joshajohnson/nano-trackball/hardware/mechanicals-snzagkeys/bottom.stp

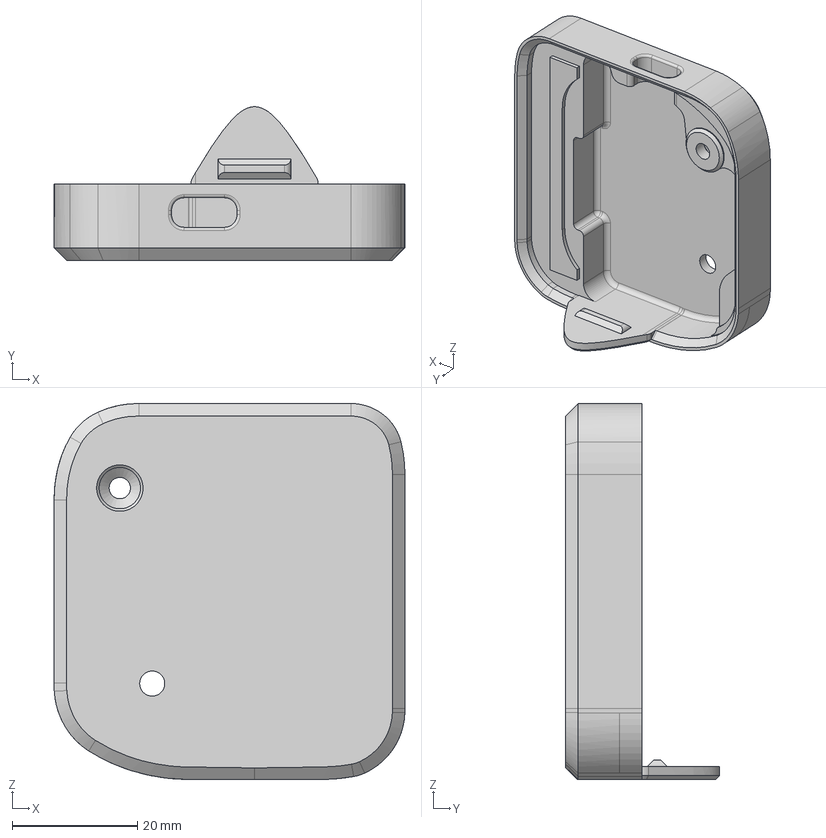
[picture p1: CAD file, 2021-08-11]
hardware/mechanicals-snzagkeys/bottom.stp
56.0 x 24.5 x 60.0 mm
