joshajohnson/nano-trackball/(list of files, cad)

Other CAD files:
hardware/mechanicals-snzagkeys/bottom.stl
