joshajohnson/nano-trackball/hardware/electronics-snzagkeys/outputs/schematic.pdf

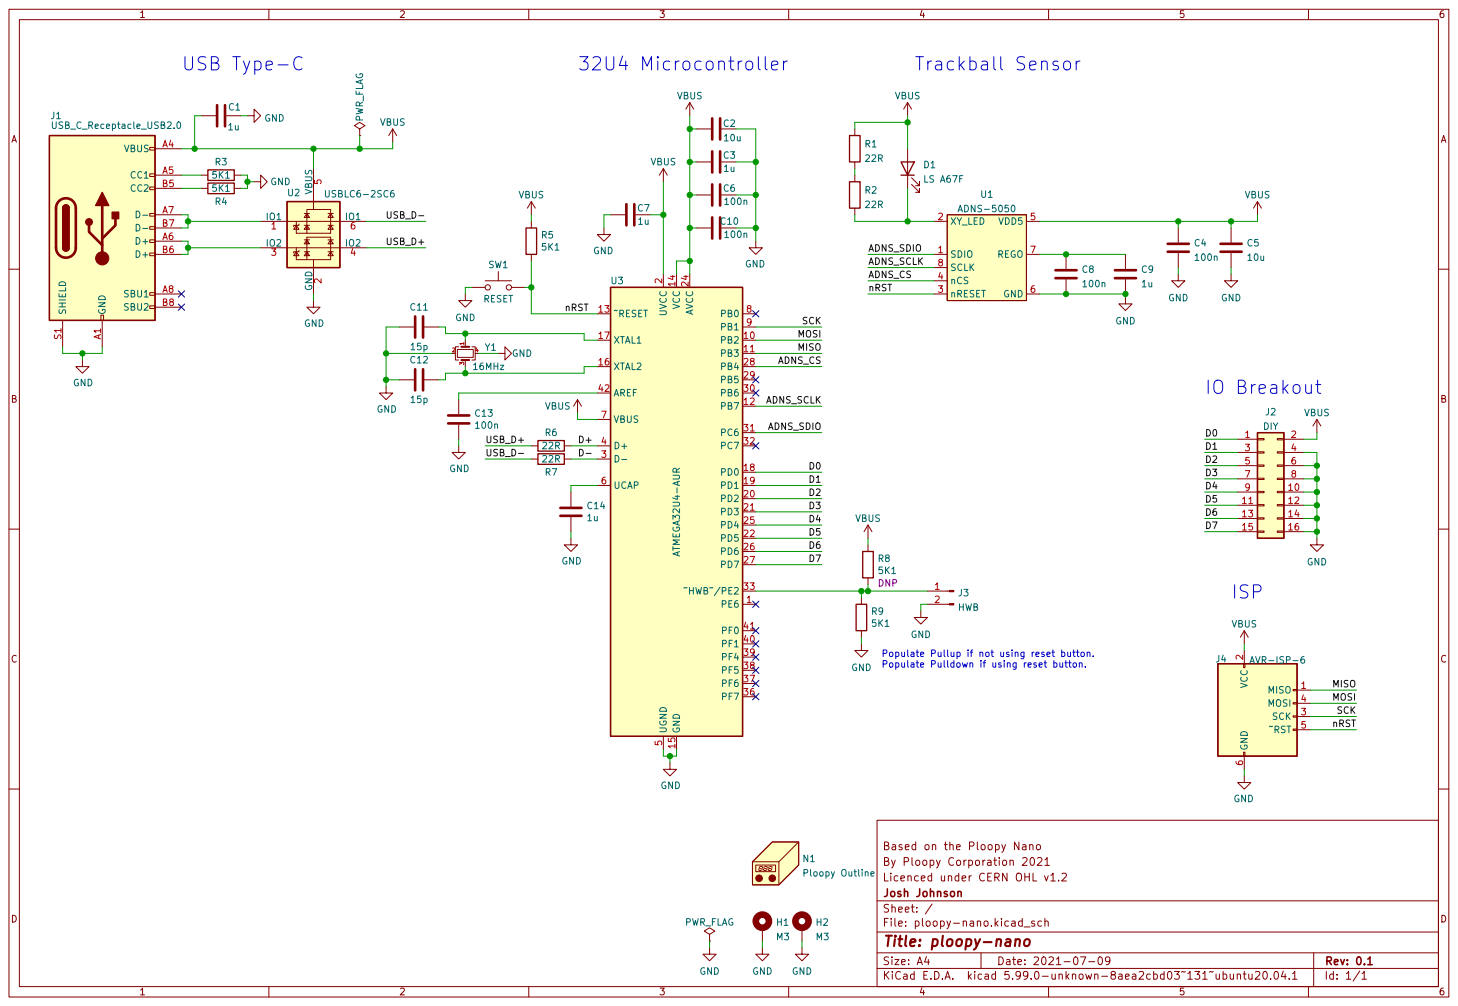
[picture p2: page 1]

2 PD2 20 PD3 21 PD5 22 AVCC 24 PD4 25 PD6 26 PD7 27 PB4 28 PB5 29 D- 3 PB6 30 PC6 31 PC7 32 ~HWB~/PE233 PF7 36 PF6 37 PF5 38 PF4 39 D+ 4 PF1 40 PF0 41 AREF 42 UGND

Populate Pullup if not using reset button.
Populate Pulldown if using reset button.

2 SCK 3 MOSI 4 ~RST 5 GND

Licenced under CERN OHL v1.2 By Ploopy Corporation 2021

File: ploopy-nano.kicad_sch Sheet: / Josh Johnson

Id: 1/1 Title: ploopy-nano
