joshajohnson/nano-trackball/hardware/electronics-snzagkeys/ploopy-nano.kicad_pcb

## KiCad design hardware/electronics-snzagkeys/ploopy-nano.kicad_pcb (2021-08-11)

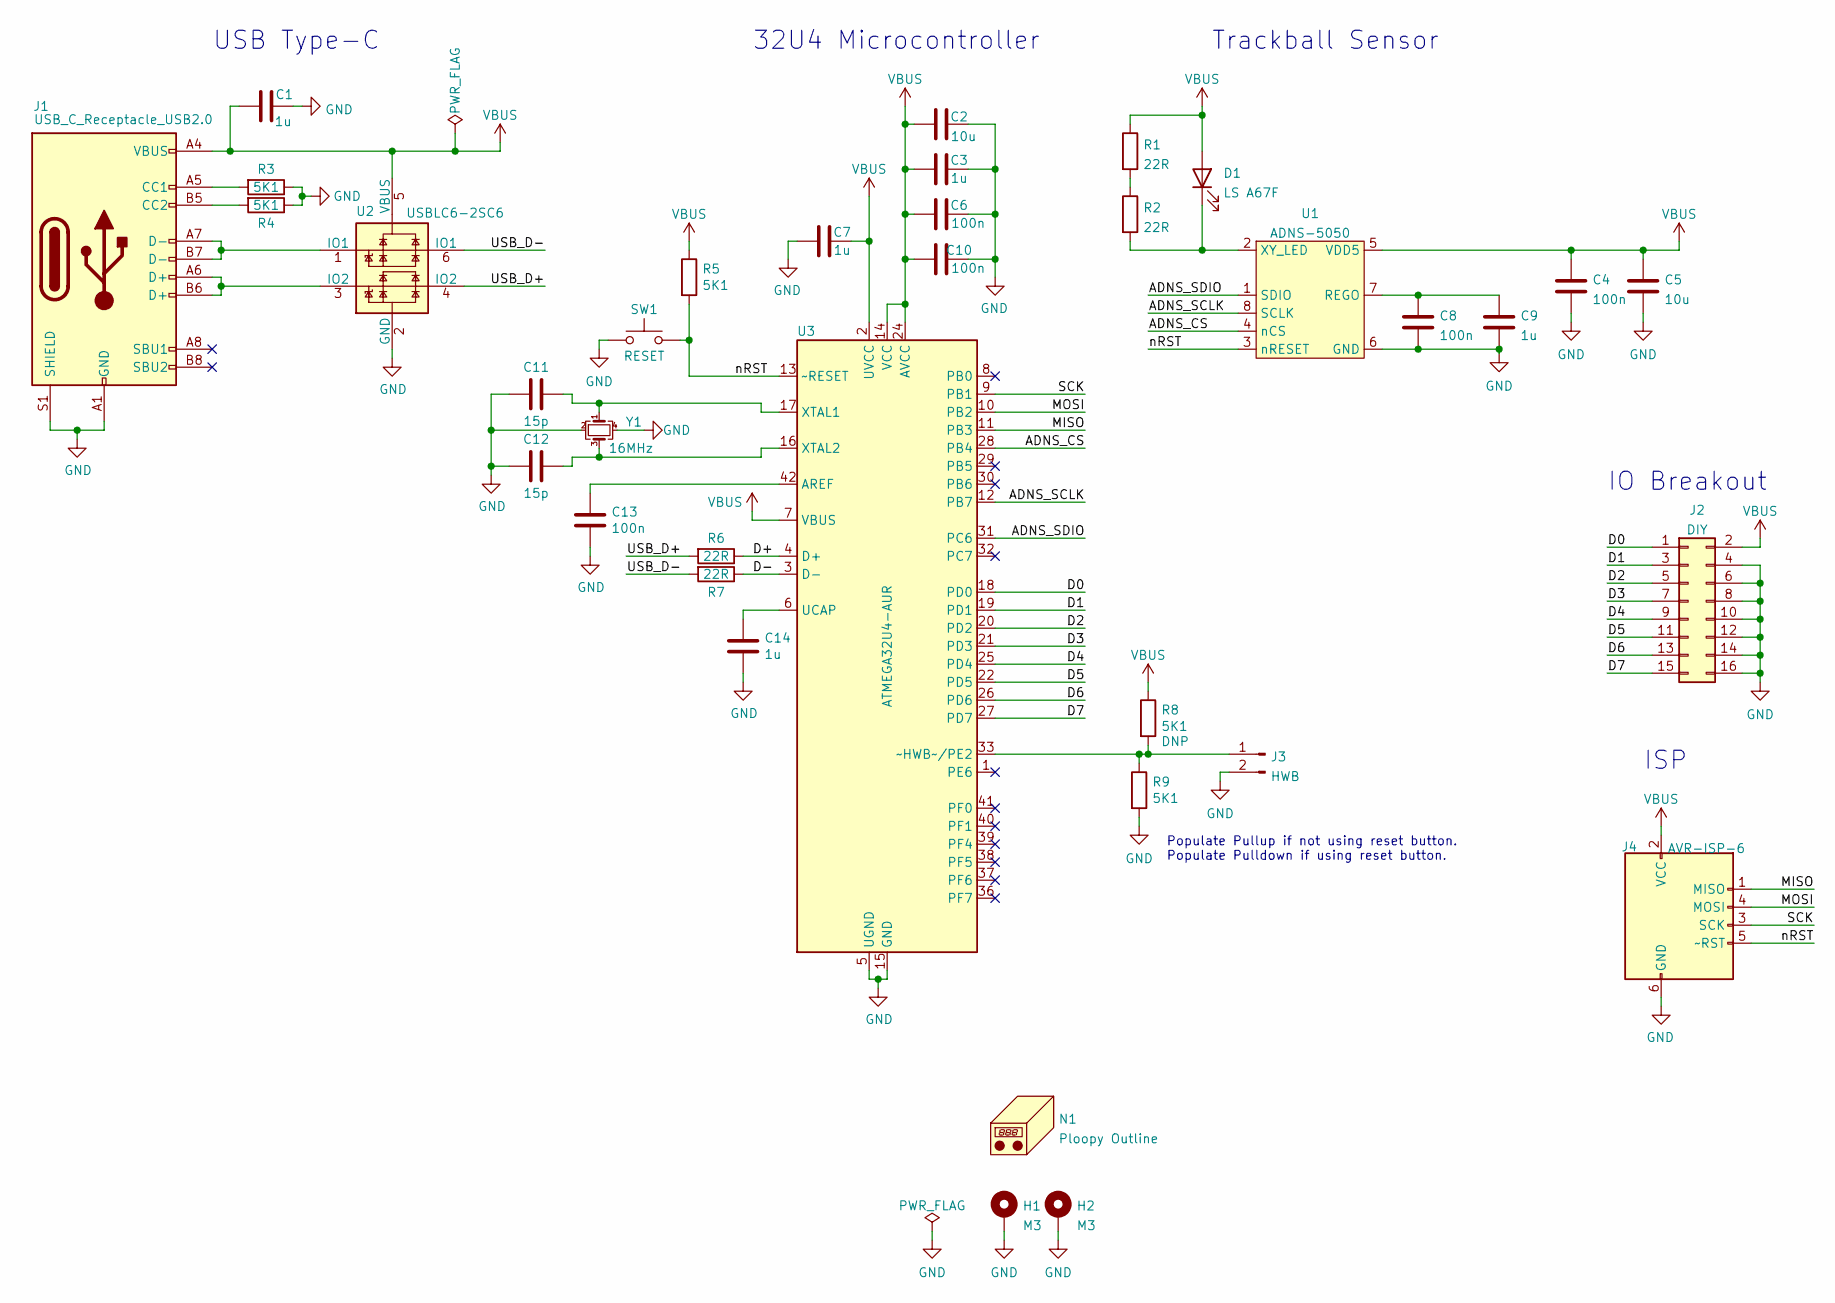
[picture p3: schematic ploopy-nano.kicad_sch]

Parts:
C1, C3, C7, C9, C14: 1u; C_0603_1608Metric; MPN CL10A105KO8NNNC; LCSC C1592
C2, C5: 10u; C_0603_1608Metric; MPN CL10A106MQ8NNNC; LCSC C1691
C4, C6, C8, C10, C13: 100n; C_0603_1608Metric; MPN CL10B104KO8NNNC; LCSC C66501
C11, C12: 15p; C_0603_1608Metric; MPN CL10C150JB8NNNC; LCSC C1644
D1: LS A67F; LO-A67F; MPN LS A67F-U2BA-1-3A4B-30-R33; LCSC C2830531
H1, H2: M3; MountingHole_3.2mm_M3_Pad_Via
J1: USB_C_Receptacle_USB2.0; USB_C_Receptacle_HRO_TYPE-C-31-M-12; MPN TYPE-C-31-M-14; LCSC C223907
J2: DIY; PinSocket_2x08_P2.54mm_Vertical
J3: HWB; PinHeader_1x02_P2.54mm_Vertical
J4: AVR-ISP-6; AVR_PROG_2.54_SMT
N1: Ploopy Outline; Ploopy-Nano
R1, R2, R6, R7: 22R; R_0603_1608Metric; MPN RC0603JR-0722RL; LCSC C108405
R3, R4, R5, R8, R9: 5K1; R_0603_1608Metric; MPN RC0603JR-075K1L; LCSC C14677
SW1: RESET; SW_Push_KMR2; MPN KMR221NGLFS; LCSC C269272
U1: ADNS-5050
U2: USBLC6-2SC6; SOT-23-6; MPN USBLC6-2SC6; LCSC C7519
U3: ATMEGA32U4-AUR; TQFP-44_10x10mm_P0.8mm; MPN ATMEGA32U4-AU; LCSC C44854
Y1: 16MHz; Crystal_SMD_3225-4Pin_3.2x2.5mm; MPN TAXM16M4RDBCCT2T; LCSC C164044

Connections:
/ADNS_CS: U1.4 (nCS), U3.28 (PB4)
/ADNS_SCLK: U1.8 (SCLK), U3.12 (PB7)
/ADNS_SDIO: U1.1 (SDIO), U3.31 (PC6)
/D0: J2.1, U3.18 (PD0)
/D1: J2.3, U3.19 (PD1)
/D2: J2.5, U3.20 (PD2)
/D3: J2.7, U3.21 (PD3)
/D4: J2.9, U3.25 (PD4)
/D5: J2.11, U3.22 (PD5)
/D6: J2.13, U3.26 (PD6)
/D7: J2.15, U3.27 (PD7)
/D+: R6.1, U3.4 (D+)
/D-: R7.1, U3.3 (D-)
/MISO: J4.1 (MISO), U3.11 (PB3)
/MOSI: J4.4 (MOSI), U3.10 (PB2)
/SCK: J4.3 (SCK), U3.9 (PB1)
/USB_D+: R6.2, U2.4 (IO2)
/USB_D-: R7.2, U2.6 (IO1)
/nRST: J4.5 (~RST), R5.2, SW1.2, U1.3 (nRESET), U3.13 (~RESET)
GND: C1.2, C2.2, C3.2, C4.2, C5.2, C6.2, C7.1, C8.2, C9.2, C10.2, C11.2, C12.2, C13.2, C14.2, H1.1, H2.1, J1.A1 (GND), J1.A12 (GND), J1.B1 (GND), J1.B12 (GND), J1.S1 (SHIELD), J2.4, J2.6, J2.8, J2.10, J2.12, J2.14, J2.16, J3.2, J4.6 (GND), R3.1, R4.1, R9.2, SW1.1, U1.6 (GND), U2.2 (GND), U3.5 (UGND), U3.15 (GND), U3.23 (GND), U3.35 (GND), U3.43 (GND), Y1.2, Y1.4
unnamed: C8.1, C9.1, U1.7 (REGO)
unnamed: C11.1, U3.17 (XTAL1), Y1.1
unnamed: C12.1, U3.16 (XTAL2), Y1.3
unnamed: C13.1, U3.42 (AREF)
unnamed: C14.1, U3.6 (UCAP)
unnamed: D1.1 (K), R2.2, U1.2 (XY_LED)
unnamed: J1.A5 (CC1), R3.2
unnamed: J1.A6 (D+), J1.B6 (D+), U2.3 (IO2)
unnamed: J1.A7 (D-), J1.B7 (D-), U2.1 (IO1)
unnamed: J1.B5 (CC2), R4.2
unnamed: J3.1, R8.2, R9.1, U3.33 (~HWB~/PE2)
unnamed: R1.2, R2.1
VBUS: C1.1, C2.1, C3.1, C4.1, C5.1, C6.1, C7.2, C10.1, D1.2 (A), J1.A4 (VBUS), J1.A9 (VBUS), J1.B4 (VBUS), J1.B9 (VBUS), J2.2, J4.2 (VCC), R1.1, R5.1, R8.1, U1.5 (VDD5), U2.5 (VBUS), U3.2 (UVCC), U3.7 (VBUS), U3.14 (VCC), U3.24 (AVCC), U3.34 (VCC), U3.44 (AVCC)

Notes on the sheet:
USB Type-C
32U4 Microcontroller
Populate Pullup if not using reset button. Populate Pulldown if using reset button.
Trackball Sensor
IO Breakout
ISP

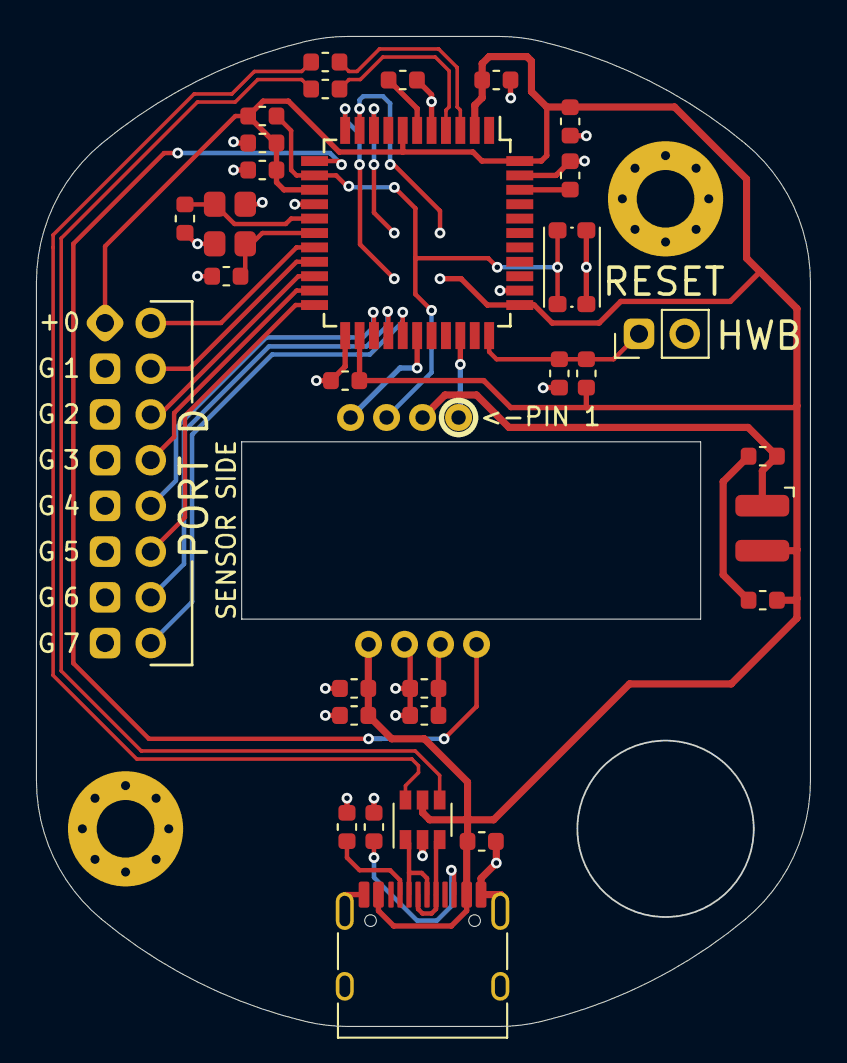
[picture p4: board ploopy-nano.kicad_pcb from above]

Board: 2 copper layers, 43.0 x 55.0 mm, 36 parts (1 on the bottom side), 33 nets.
